starduststorm/earthvenusmars/case/bottom_case.stl

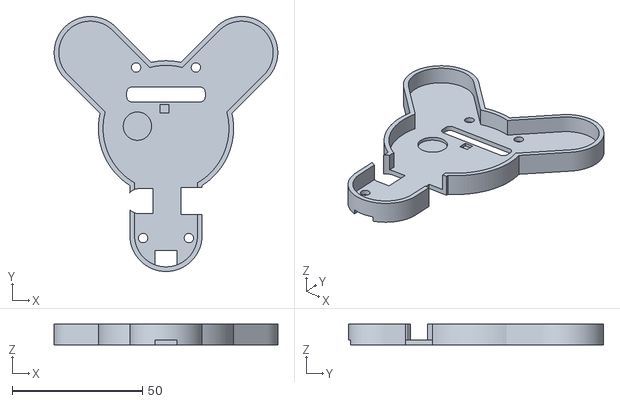
[picture p6: CAD file, 2023-03-20]
case/bottom_case.stl
86.0 x 98.1 x 8.00
