starduststorm/earthvenusmars/programmer/caddy.stl

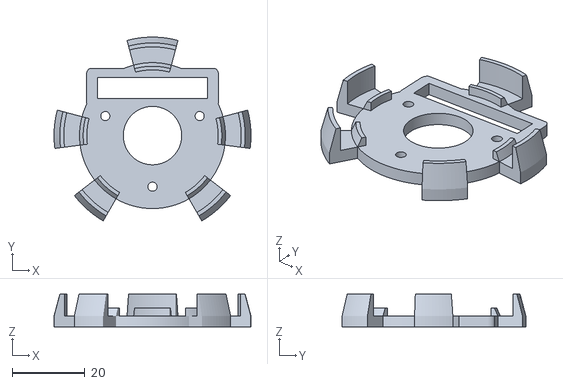
[picture p7: CAD file, 2021-11-03]
programmer/caddy.stl
54.0 x 50.4 x 9.00
