starduststorm/earthvenusmars/case/top_case.stl

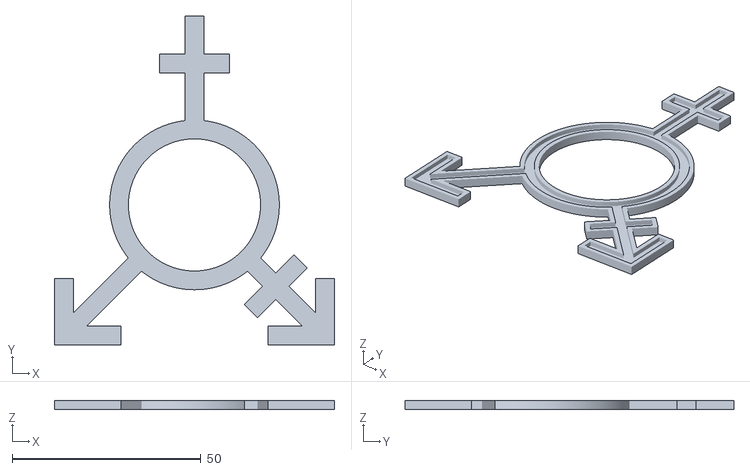
[picture p8: CAD file, 2023-03-20]
case/top_case.stl
74.3 x 87.2 x 2.30
