starduststorm/earthvenusmars/(list of files, cad)

Other CAD files:
case/PI3MK3M_bottom_case.3mf
