starduststorm/earthvenusmars/src/controls.h

#ifndef CONTROLS_H
#define CONTROLS_H

#include <vector>
#include <functional>
#include "Adafruit_FreeTouch.h"

class HardwareControl {
  friend class HardwareControls;
protected:
  virtual void update() = 0;
  int pin;
public:
  HardwareControl(int pin) : pin(pin) {};
  virtual ~HardwareControl() {};
};

/* ------------------ */

typedef std::function<void(uint32_t)> DialHandler;

class AnalogDial : public HardwareControl {
  DialHandler changeHandler = [](uint32_t){};

  uint32_t lastValue = UINT32_MAX;
  unsigned long lastChange;
  bool firstUpdate = true; // always call handler on first update to help set initial values

  void update() {
    uint32_t value;
    if (readValueFunc) {
      value = (*readValueFunc)();
    } else {
      value = analogRead(pin);
    }
    // potentiometer reads are noisy, jitter may be around ±30 or so. 
    // Wait for significant change to notify the handler, but then still allow smooth updates as the pot is turned
    bool significantChange = abs((int)lastValue - (int)value) > updateThreshold;
    bool recentSignificantChange = (millis() - lastChange < smoothUpdateDuration);
    bool endpointsChange = lastValue != value && (value == 0 || value == maxValue);
    
    if (significantChange || recentSignificantChange || endpointsChange || firstUpdate) {
      // logf("pot update: significantChange = %i [%u - %u > %u], recentSignificantChange = %i, endpointsChange = %i", significantChange, lastValue, value, updateThreshold, recentSignificantChange, endpointsChange);
      if (significantChange || endpointsChange) {
        lastChange = millis();
        lastValue = value;
      }
      changeHandler(value);
    }
    firstUpdate = false;
  }

public:
  unsigned updateThreshold = 40; // Value threshold to suppress jitter in the thumbdial
  unsigned smoothUpdateDuration = 500; // Duration (ms) to call handler on every change after threshold is met

  uint32_t (*readValueFunc)(void) = NULL;
  uint32_t maxValue = 1023;

  AnalogDial(int pin) : HardwareControl(pin) {
  }

  void onChange(DialHandler handler) {
    changeHandler = handler;
  }
};

/* ----------------------- */

typedef std::function<void(void)> ButtonHandler;

class SPSTButton : public HardwareControl {
  typedef enum {
    singlePress,
    doublePress,
    longPress,
    doubleLongPress,
    buttonDown,
    buttonUp,
    handlerTypeCount,
  } HandlerType;

  uint32_t buttonDownTime = 0;
  uint32_t singlePressTime = 0;
  bool waitForButtonUp = false;
  
  bool didInit = false;
  
  ButtonHandler *handlers[handlerTypeCount] = {0};

  virtual void initPin(int pin) {
    pinMode(pin, INPUT_PULLUP);
  }

  void onHandler(HandlerType type, ButtonHandler handler) {
    // we go through this handlers dance in order to not spend memory on expensive std::functions for handlers not in use.
    if (handlers[type]) {
      delete handlers[type];
    }
    handlers[type] = new ButtonHandler(handler);
  }

  void doHandler(HandlerType type) {
    logdf("Do button handler: %i", type);
    if (handlers[type])
      (*(handlers[type]))();
  }

  void update() {
    if (!didInit) {
      initPin(pin);
      didInit = true;
    }
    bool buttonPressed = isButtonPressed();
    long readTime = millis();

    if (!buttonPressed && buttonDownTime != 0) {
      doHandler(buttonUp);
    }

    if (waitForButtonUp) {
      if (!buttonPressed) {
        waitForButtonUp = false;
      }
    } else {
      if (!buttonPressed && singlePressTime != 0) {
        if ((!handlers[doublePress] && !handlers[doubleLongPress]) || readTime - singlePressTime > doublePressInterval) {
          // double-press timeout
          doHandler(singlePress);
          singlePressTime = 0;
        }
      }
      if (!buttonPressed && buttonDownTime != 0) {
        if (singlePressTime != 0) {
          // button-up from second press
          doHandler(doublePress);
          singlePressTime = 0;
        } else {
          singlePressTime = readTime;
        }
      } else if (buttonPressed && buttonDownTime == 0) {
        if (readTime - singlePressTime < 15) {
          // The metal buttons sometimes have state jitter leading to a button down around ~10ms after button up. We'll ignore.
          logf("Button jitter detected at %lums, ignoring", readTime - singlePressTime);
          return;
        }
        buttonDownTime = readTime;
        doHandler(buttonDown);
      } else if (buttonPressed && readTime - buttonDownTime > longPressInterval) {
        if (singlePressTime != 0) {
          doHandler(doubleLongPress);
          singlePressTime = 0;
        } else {
          doHandler(longPress);
        }
        // waiting for button up prevents duplicate calling of the longpress handler
        waitForButtonUp = true;
      }
    }

    if (!buttonPressed) {
      buttonDownTime = 0;
    }
  }

public:
  uint16_t longPressInterval = 500;
  uint16_t doublePressInterval = 400;

  SPSTButton(int pin) : HardwareControl(pin) { }
  ~SPSTButton() {
    for (int i = 0; i < handlerTypeCount; ++i) {
      if (handlers[i]) {
        delete handlers[i];
      }
    }
  }

  virtual bool isButtonPressed() {
    // HACK: on EVM hardware 2+, the Colors button is wired to Arduino Zero's TX LED pin, which causes sporatic HIGH reads
#if EVM_HARDWARE_VERSION >= 2
    noInterrupts();
    pinMode(pin, INPUT_PULLUP);
#endif
    int read = (digitalRead(pin) == LOW);
#if EVM_HARDWARE_VERSION >= 2
    interrupts();
#endif
    return read;
  }

  // guestural handlers that handle all timeouts/delays, i.e. singlePress handler will only be called if doublePress is not triggered.
  void onSinglePress(ButtonHandler handler) {
    onHandler(singlePress, handler);
  }
 
  void onDoublePress(ButtonHandler handler) {
    onHandler(doublePress, handler);
  }

  void onLongPress(ButtonHandler handler) {
    onHandler(longPress, handler);
  }

  void onDoubleLongPress(ButtonHandler handler) {
    onHandler(doubleLongPress, handler);
  }

  // simple handlers. onButtonUp may be called in addition to the e.g. longPress handler if both are set. onButtonUp will be called twice during doublePress.
  void onButtonDown(ButtonHandler handler) {
    onHandler(buttonDown, handler);
  }

  void onButtonUp(ButtonHandler handler) {
    onHandler(buttonUp, handler);
  }
};

class TouchButton : public SPSTButton {
  Adafruit_FreeTouch *touchObj;
  void initPin(int pin) { } // no-op, skip SPSTButton init and do pin init in constructor
  bool touchRegistered = false;
  uint16_t avgSample = 0;
  const uint16_t avgSampleCount = 3;
public:
  uint16_t touchThreshold = 500; // sample above (10-bit) threshold will be considered touch down
  uint16_t touchReleaseBuffer = 100; // sample must fall below threshold-buffer for touch release

  TouchButton(int pin, oversample_t oversample, series_resistor_t seriesResistor, freq_mode_t freqMode) : SPSTButton(pin) {
    touchObj = new Adafruit_FreeTouch(pin, oversample, seriesResistor, freqMode);
    touchObj->begin();
  }

  ~TouchButton() {
    delete touchObj;
  }

  bool isButtonPressed() {
    uint16_t sample = touchObj->measure();
    if (sample == (uint16_t)-1) {
      logf("touch sample failed");
      return touchRegistered;
    }
    assert(touchThreshold > touchReleaseBuffer, "touchThreshold must be > touchReleaseBuffer");

#if EVM_HARDWARE_VERSION==3
  /*
  I think the pin 17 touch pad has a higher baseline read perhaps because it routes through a via underneath the mcu. Let
  Idle reads on pins 8, 17, and 19 across 3 different units:
  Touch Samples: 181, 323, 147
  Touch Samples: 175, 317, 142
  Touch Samples: 179, 322, 145
  */
  if (pin == 17) {
    sample = map(sample, 310, 1023, 150, 1023);
  }
#endif

    avgSample = ((avgSampleCount * avgSample) + sample) / (avgSampleCount + 1);
    if (avgSample > touchThreshold) {
      touchRegistered = true;
    } else if (avgSample < (uint32_t)(touchThreshold - touchReleaseBuffer)) {
      touchRegistered = false;
    }
    return touchRegistered;
  }

  int measure() {
    return touchObj->measure();
  }
};

/* --------------------- */

class HardwareControls {
private:
  std::vector<HardwareControl *> controlsVec;
public:
  ~HardwareControls() {
    for (auto control : controlsVec) {
      delete control;
    }
    controlsVec.clear();
  }

  SPSTButton *addButton(int pin) {
    SPSTButton *button = new SPSTButton(pin);
    controlsVec.push_back(button);
    return button;
  }

  TouchButton *addTouchButton(int pin, oversample_t oversample=OVERSAMPLE_4, series_resistor_t seriesResistor=RESISTOR_0, freq_mode_t freqMode=FREQ_MODE_NONE) {
    TouchButton *button = new TouchButton(pin, oversample, seriesResistor, freqMode);
    controlsVec.push_back(button);
    return button;
  }

  AnalogDial *addAnalogDial(int pin) {
    AnalogDial *dial = new AnalogDial(pin);
    controlsVec.push_back(dial);
    return dial;
  }

  void update() {
    for (HardwareControl *control : controlsVec) {
      control->update();
    }
  }
};

#endif
