starduststorm/earthvenusmars/(commit log)

2020-10-08 initial commit of trans symbol wearable led project, wip, just finish first pass on edge-cut-drawing code
    [leds.sch, trans_symbol.kicad_pcb, trans_symbol.sch]
2020-10-08 fix spokes to match the non-uniform spacing that the symbol apparently has
    [trans_symbol.kicad_pcb]
2020-10-09 start working on spokes
    [leds.sch, trans_symbol.kicad_pcb, trans_symbol.sch]
2020-10-10 clean up various point-like object types; tweak Edge.Cuts to be precise overlap in order to fix pcbnew thinking it wasn't a closed shape, but turns out this was also a bug fixed in kicad-5.1.3 so I'm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
    [leds.sch, trans_symbol.kicad_pcb]
2020-10-11 first pass on complete trans symbol
    [trans_symbol.kicad_pcb]
2020-10-11 flip arrow without cross to save a via
    [trans_symbol.kicad_pcb]
2020-10-11 fix pixel orientation on arrow & cross
    [trans_symbol.kicad_pcb]
2020-10-11 hide pixel reference labels
    [trans_symbol.kicad_pcb]
2020-10-20 fix pixel orientation on arrow; add via for GND out of each LED (we cannot delete vias programmatically due to a crasher, so layout is manual from here on out); choose pins for SPI; wire up SPI & USB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
    [leds.sch, trans_symbol.kicad_pcb, trans_symbol.sch]
2020-10-20 add pcb layout as it was before adding vias, as a backup
2020-10-20 add test code for running leds on the chosen SPI pins
2020-10-20 add symbol cache lib to repo; one last tweak to layout to shift led placement - comment out via code in order to leave vias intact (where they are is fine) without crashing
2020-10-20 first pass on manual layout of board including led power traces & samd circuitry; key idea: take out the usb port and solder the usb data & power directly to the board, i.e. it'll have its own cable 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
    [leds.sch, trans_symbol.kicad_pcb, trans_symbol.sch]
2020-10-20 add a decoupling capacitor on +5V for LEDs
    [leds.sch, trans_symbol.kicad_pcb, trans_symbol.sch]
2020-10-20 re-add 5V line that was removed
    [trans_symbol.kicad_pcb]
2020-10-20 re-layout chip circuitry to clean it up a bit and make room for a button on each spoke; add a stub for a button
    [trans_symbol.kicad_pcb, trans_symbol.sch]
2020-10-21 add an i2s microphone on default arduino zero i2s pins
    [trans_symbol.kicad_pcb, trans_symbol.sch]
2020-10-21 add three buttons; untested beacuse I've bricked my samd board again, trying to get it to come back alive
    [trans_symbol.kicad_pcb, trans_symbol.sch]
2020-10-22 rename project to something a bit more fun
    [earthvenusmars.kicad_pcb, earthvenusmars.sch]
2020-10-22 move kicad files to ./board
    [earthvenusmars.kicad_pcb, earthvenusmars.sch, leds.sch]
2020-10-22 move button 2 to pin 30 to avoid a via
    [earthvenusmars.kicad_pcb, earthvenusmars.sch]
2020-10-22 add kicad symbol cache which was somehow missing
2020-11-01 make platformio project cause Arduino.app does't even support cmd+clicking a symbol; crib util.h from belt
2020-11-02 map buttons pins correctly, tested with samd21g_breakout_v1 using arduino zero firmware
    [main.cpp]
2020-11-24 proof of concept for entering low-power state when the brightness dial is all the way down, using the adc, then waking the system back up when the brightness dial is turned up again
    [earthvenusmars.kicad_pcb, earthvenusmars.sch]
2020-11-25 add pads on back for bootloader programming/reset and for driving the leds externally
    [earthvenusmars.kicad_pcb, earthvenusmars.sch]
2020-11-25 fix led GND vias that were isolated from or poorly connected to the GND fill
    [earthvenusmars.kicad_pcb]
2020-12-04 scoot pot dial around a bit
    [earthvenusmars.kicad_pcb]
2020-12-04 add footprint for 3-hole safety pin attachment point; place 3 attachments on board; scoot things around for neatness/GND flow
    [earthvenusmars.kicad_pcb, earthvenusmars.sch]
2020-12-07 remove my name from the KMR731NG LFS footprint
    [earthvenusmars.kicad_pcb]
2020-12-07 add kicad fp-lib-table file that seems to be for project-specific libraries
2020-12-07 sign it
    [earthvenusmars.kicad_pcb]
2020-12-07 fix mic gnd connection; tweaks for printing/assembly
    [earthvenusmars.kicad_pcb]
2020-12-07 ensure microphone is present in footprint position (centroid) file
    [earthvenusmars.kicad_pcb]
2020-12-08 add part number to a "Designation" field that will be output by the bom_csv_grouped_by_value script that looks like a better alternative than what I sent to the fab this time; remove (opal) from part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
    [earthvenusmars.kicad_pcb, earthvenusmars.sch]
2020-12-08 crib a bunch of code from the belt to start fleshing out the software side of this project. builds, but untested
2020-12-08 stop trying to sprintf floats because arduino-samd-core cannot sprintf floats (and this was crashing, usually)
    [main.cpp, util.h]
2020-12-09 just in time to negotiate with the fab, rewire the whole damn thing because it was really bothering me that the leds in the cross and arrow were not oriented consistently; also remove paste from debu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
    [earthvenusmars.kicad_pcb]
2020-12-09 change APA102 footprint to use the 6-pad variant, not 8. these are cheaper from pcbway, though still expensive enough that I'm going to order my own later anyawy
    [earthvenusmars.kicad_pcb]
2020-12-09 schematic changes for apa102-2020-6 footprint
    [leds.sch]
2020-12-09 change USB pin connector to 5-pin to handle the ID pin from usb-micro
    [earthvenusmars.kicad_pcb, earthvenusmars.sch]
2020-12-09 I deleted a single layout alignment target and kicad generated this gigantic diff
    [earthvenusmars.kicad_pcb]
2020-12-14 rearrange F.Fab and B.Fab layers for clarity to aid assembly engineers; use the larger 0603 footprint for ferrite bead because it's way more manageable and I have the parts
    [earthvenusmars.kicad_pcb, earthvenusmars.sch]
2020-12-15 hide J4 connector label ugh
    [earthvenusmars.kicad_pcb]
2020-12-15 correct part number for new ferrite bead
    [earthvenusmars.sch]
2020-12-26 first WIP pattern for working prototype!
2020-12-27 more flag palettes; add concept for "Coupling" pattern
2020-12-28 factor adc/power code into power.h and clean it a up a little; add sleep/wake animations; buttons advance patterns for now
2020-12-29 actually add power.h; tweaks to Downstream & FastLED delay
2021-01-04 clean up new edge-directions code in BitsFiller, generalize flowing to allow fade-up on each path; BitsFiller color cycling; argument logging for assertions
2021-01-05 reduce flicker due to brightness dial jitter using AnalogDial class from the belt; fix a bug where we wouldn't enter sleep mode when the brightness dial was quickly thrown to its lowest position
    [controls.h, main.cpp, power.h]
2021-01-11 add new ChargePattern which will probably be run with buttons later on; add Bit handlers to BitsFiller to allow for colors customization etc., rather than trying the ever-expanding list of enums and 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
2021-01-17 use pixel buffers to fix global fadedown in BitFiller
    [PatternManager.h, drawing.h, ledgraph.h, patterns.h]
2021-01-18 use new buffers to give Coupling a much more polished treatment
2021-01-18 Basic button functions for changing patterns; handle buttons with lambdas instead of function ptrs; access Charge pattern using long presses; start working on color/palette changing via button presse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
2021-01-19 color/palette selection for Charge
2021-01-19 fix a signedness issue in reducing pot jitter; log brightness changes
    [controls.h, power.h]
2021-01-31 committing some fft-related stubs that I had only just started testing when I broke my prototype. like a week ago fml I need to make a new one
    [PatternManager.h, patterns.h]
2021-01-31 add an OpenSCAD-based rough design for a case for the pcb; needs a cutout for the brightness thumbdial and a way to snap the halves together
    [shell_case.scad]
2021-01-31 add a case cutout for the thumbdial
    [shell_case.scad]
2021-02-05 fix thumbdial cutout position
    [shell_case.scad]
2021-02-11 stub for new kicad project for a programmer board with spring pins; move project-specific footprints into a shared footprints lib
    [earthvenusmars.kicad_pcb, programmer.kicad_pcb, programmer.sch]
2021-02-13 disable Sound-related test code because it is crashing on launch again (or otherwise has bricked my boards); fix "test pattern" code to not instantiate test pattern at global scope; random small twea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
    [PatternManager.h, controls.h, patterns.h, power.h]
2021-02-13 first complete pass at a programmer pcb & accompanying 3d-printable caddy; create footprints for programmer pins including the first fab run as well as a new design for v2 programmer pins
    [caddy.scad, programmer.kicad_pcb, programmer.sch]
2021-02-13 adopt v2 programmer pins on EVM board
    [earthvenusmars.kicad_pcb, earthvenusmars.sch]
2021-02-13 I reloaded *one* footprint from the footprint library and kicad generated this vomit of a diff
    [earthvenusmars.kicad_pcb]
2021-02-13 fix build issues; tested and works
    [PatternManager.h]
2021-02-13 set Sound up for future testing; it's not crashing now; but it's also not picking up any audio, hardware suspected faulty since test program worked before and doesn't now
    [PatternManager.h, patterns.h]
2021-02-14 change screw drill size to 1.25mm for M3 screws (which apparently have 3mm major dimension and expect a 2.5mm drill)
    [caddy.scad, programmer.kicad_pcb]
2021-02-14 tweak to avoid "Object may not be a valid 2-manifold" issue in OpenSCAD, I think because this tweak avoids a coincident external edge
    [caddy.scad]
2021-02-14 correct footprint for SMD SWD socket (part 3221-10-0300-00 ordered from digikey)
    [programmer.kicad_pcb, programmer.sch]
2021-02-14 decorate a little
    [programmer.kicad_pcb]
2021-02-14 tiny polish tweaks
    [programmer.kicad_pcb]
2021-02-14 decoration on bottom too
    [programmer.kicad_pcb]
2021-03-15 Sound is working! two test patterns present, not great yet; fft frequency binning is unfortunately linear, but at least it's reliable; i2s power consumption while sleeping not tested yet
2021-04-28 WIP on a snap notch for case
    [notch.scad]
2021-04-28 committing stl for caddy
    [caddy.stl]
2021-04-28 minor changes to soundbits; memory logging improvements; vasprintf bugfix; wip concept for heartbeat pattern
    [AudioManager.h, PatternManager.h, main.cpp, palettes.h, patterns.h, util.h]
2021-04-28 scoot a trance around under the samd21 for aesthetics
    [earthvenusmars.kicad_pcb]
2021-04-29 change usb port footprint to 4-pin 2.54mm. I still don't like my options for using a usb micro port on the back. not that glue is any better...
    [earthvenusmars.kicad_pcb, earthvenusmars.sch]
2021-05-14 checkpoint for shell case that prints correctly on my new prusa i3 mk3s by including more of a back panel. fits board correctly though doesn't quite fit a bar pin
    [shell_case.scad]
2021-05-14 tweak to add print tolerance to progarmmer caddy; I had to file the first one down a little to fit
    [caddy.scad]
2021-05-14 tweak thumbdial position and cable cutout
    [shell_case.scad]
2021-05-31 concept for smd usb pads on bottom of board + a pass at the shell case cable management for that
    [earthvenusmars.kicad_pcb, earthvenusmars.sch, shell_case.scad]
2021-05-31 tweak some traces and vias for slightly better gnd flow
    [earthvenusmars.kicad_pcb]
2021-05-31 new plan for spoke buttons: touch buttons. schematic changes for new button layout; add footprints for new touch buttons; rewire new and existing buttons; re-layout linreg and power circuity for bett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
    [earthvenusmars.kicad_pcb, earthvenusmars.sch]
2021-06-01 bunch of spacing & routing tweaks
    [earthvenusmars.kicad_pcb]
2021-06-01 reposition buttons farther away from touch buttons to avoid accidental touch + better overall spacing
    [earthvenusmars.kicad_pcb, earthvenusmars.sch]
2021-06-01 decorate with a larger trans symbol and add a new signature
    [earthvenusmars.kicad_pcb]
2021-06-01 add hackable ports for led spi & i2c for who knows what reason
    [earthvenusmars.kicad_pcb, earthvenusmars.sch]
2021-06-01 reconnect vddio back to 3.3v, got disconnected likely by b136dde during redo
    [earthvenusmars.kicad_pcb]
2021-06-02 change 1uF cap to an 0603 because the 0805 one was so thick it was impacting the case design
    [earthvenusmars.kicad_pcb, earthvenusmars.sch]
2021-06-02 no-conn flags to suppress old drc errors
    [leds.sch]
2021-06-02 move led & i2c hack pads closer to programmer pads in case I ever want to add those to a programmer caddy
    [earthvenusmars.kicad_pcb]
2021-06-02 move crystal down a bit for compactness
    [earthvenusmars.kicad_pcb]
2021-06-05 move usb pads up a little to give the usb cables more room for stabilization before poking out the bottom of the device
    [earthvenusmars.kicad_pcb, shell_case.scad]
2021-06-05 add a usb-micro port (I know). including both usb styles on this prototype stage to try them both out and compare
    [earthvenusmars.kicad_pcb, earthvenusmars.sch]
2021-06-05 add a thermistor that I can use to manage thermals
    [earthvenusmars.kicad_pcb, earthvenusmars.sch]
2021-06-05 scoot some components around slightly to center on 90,90
    [earthvenusmars.kicad_pcb]
2021-06-05 move touch pin 2 because AdaFruit_FreeTouch only supports PA02 thru PA07 for self-capacitance; run power to mic and VDDANA on the far side of the VDDIO capacitor to save a via, I think this'll be fin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
    [earthvenusmars.kicad_pcb, earthvenusmars.sch]
2021-06-06 remove solder paste that stubbornly keeps getting added to some pads
    [earthvenusmars.kicad_pcb]
2021-06-06 futz with the copper near the usb port gnd; hide c13 label; prep for fab
    [earthvenusmars.kicad_pcb]
2021-06-08 slightly reduce the percentage of time that mars & venus are chosen during coupling
2021-06-08 refactor most bitdirections-related code to use a memory-compacted EdgeTypesPair implementation rather than the god-awful vector implementation I had before. sizeof(Bit) down to 24 from 36; shaved 20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
    [ledgraph.h, patterns.h]
2021-06-14 tweak touch pad footprints for appearance after seeing how v2 prints look
    [earthvenusmars.kicad_pcb]
2021-06-16 thermistor series resister marked as 10k
    [earthvenusmars.kicad_pcb, earthvenusmars.sch]
2021-06-17 fix a bug where the brightness dial wouldn't get an interrupt at program start, leaving brightness at 0 until changed. this was only reproducing on evm board v2, I don't know why
    [controls.h, power.h]
2021-06-17 add build env for board v2; add support for qtouch capacitive touch pads via the Adafruit FreeTouch library; basic implementation of button configuration for board v2; fix a hang in audio if no mic i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
    [AudioManager.h, controls.h, main.cpp]
2021-06-17 add support for thermistor reads with a custom analogRead function that restores settings needed by the ADC interrupt-driven brightness dial; scale brightness down as temperature increases (partially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
    [earthvenusmars.sch]
2021-06-18 overhaul color system for consistency across patterns; add support for several new flag types; add palette autorotate as a toggle; add pattern rotate (timeout/random); support board v2 and partially 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
2021-06-21 change µ to u in micro-faraday labels for consistency and cause it's easier to search for and everyone understands it
    [earthvenusmars.sch]
2021-07-01 remove USB pads; scoot USB port around a little; revert bottom board to be rounded again, no need to accomodate usb cable; scoot brightness dial around for case/usability considerations; lots of trac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
    [earthvenusmars.kicad_pcb]
2021-07-01 shell case updates for board tweaks; also add cutouts for thermistor, remove usb pad channel
    [shell_case.scad]
2021-07-01 work around an issue where the colors button was triggering sporatically on its own
    [controls.h]
2021-07-01 factor some pattern-palette update stuff for cleanliness; compile out thermistor code on v1; add pride flags to main palette rotation; tweaks
2021-07-01 very dirty gain management for sound responsiveness, implemented the morning before I was gonna demo this; also a tweak for Downstream to avoid time drift
    [patterns.h]
2021-07-11 add a power switch. ugh. but it's going to prevent the device from waking up in a backpack and stuff; not to mention power draw is way too high for sleep right now
    [earthvenusmars.kicad_pcb, earthvenusmars.sch]
2021-07-11 clean up schematic a bit; reroute +5v to save a via
    [earthvenusmars.kicad_pcb, earthvenusmars.sch]
2021-07-14 move github url slightly up
    [earthvenusmars.kicad_pcb]
2021-07-25 small tweaks to Fab layers for fab run; add two NPTHs for potential case attachment
    [earthvenusmars.kicad_pcb]
2021-07-25 add missing footprint for power switch ('no license' footprint from https://gitlab.geofront.co.uk/mwoods/kicad-libs/blob/master/kicad-library-master/mods/COPAL-MFS101D-6-Z.kicad_mod)
2021-07-26 refill zones
    [earthvenusmars.kicad_pcb]
2021-07-28 put a bandaid over a type issue stemming from EdgeTypes still being around as uint8_t to manage bitwise-operated EdgeType, since EdgeType is an unbased enum
    [ledgraph.h]
2021-07-29 fix an issue where leds might blink briefly on wake from sleep
    [power.h]
2021-07-29 only create a std::function for in-use button handlers since each is at least 16 bytes, leading my 5 'buttons' to consume 688 bytes cold. down to ~300 now
2021-07-29 WIP: move pin config out of main into config.h; move controls out of main into pattern manager; pattern manager always runs Charge; charge is activated by touch-down and made persistent with long-pre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
    [PatternManager.h, config.h, ledgraph.h, main.cpp, patterns.h, util.h]
2021-07-30 rework buffering so that there's a global pixel buffer, and one per-pattern, rather than one per-BitsFiller. this saves a lot of memory while looking pretty much the same. consolidate CustomDrawingCo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
    [PatternManager.h, drawing.h, ledgraph.h, main.cpp, patterns.h]
2021-07-30 fix v1 with new chargepattern changes
    [PatternManager.h, main.cpp]
2021-07-30 found the crash - this return was removed accidentally when I removed the unused leaf behavior; crash would happen when a bit both a) hit a leaf with nowhere to go and b) ran over its lifespan, withi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
    [patterns.h]
2021-07-30 remove debug code from Charge reword & memory improvements; overall memory usage hard to measure but I'd guess I shaved a good 1-2KB off the worst use SRAM cases
2021-08-02 more micro-optimizations, this time avoid copying a vector of fft data
    [AudioManager.h, patterns.h]
2021-08-11 new welcome animations for power-on & pattern autorotate; long-presses for both buttons now always enable autorotate, even if it was already on, shows the welcome again, for predictability's sake
2021-08-12 fade down the active pattern somewhat while Charge is running
2021-08-12 reset tracked flag colors on pattern change since some patterns dirty them
    [PatternManager.h, palettes.h]
2021-08-12 fix an issue where we were creating a FlagColorManager:PaletteRotation (and logging) on every frame of the pattern-rotation-welcome animation
    [PatternManager.h]
2021-08-12 lower temperature-scaling threshold cause it's quite easy to get the device to 60+ degrees C which is hot
2021-08-13 fix a potential crasher on v1
    [PatternManager.h]
2021-08-16 add scripts for flashing bare devices using gdb + blackmagic probe; update programmer README
2021-08-16 add some part numbers to designation fields because fab often doesn't find the parts in other fields
    [earthvenusmars.sch]
2021-08-17 unhide SW3 and RV1 labels for fab use
    [earthvenusmars.kicad_pcb]
2021-09-14 i just....... you know when you spend hours and hours on a project to make sure everything is functional & you triple check everything, only to go on break it when you remove some debugging code? I g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
    [earthvenusmars.kicad_pcb, earthvenusmars.sch]
2021-09-15 enlargen mounting holes somewhat; scoot labels around for aesthetic
    [earthvenusmars.kicad_pcb]
2021-09-15 don't clear Charge on pattern change, that way you can put on your preferred spoke and it'll stay on during pattern autorotate
2021-10-01 fix a bug where brightness was reduced due to charge pattern appearing to be active; problem more apparently now that charge pattern isn't cleared on pattern change
    [patterns.h]
2021-10-01 faster max for temperature downscaling
2021-10-01 update programmer rig to have space for a the bar pin attachments I've been using, otherwise once a bar pin is attached the programmer rig can no longer be used
    [caddy.scad, caddy.stl, programmer.kicad_pcb]
2021-10-27 actually enlarge drills for top mounting holes - 07b4abe only enlarged the footprint, which ended up being plating around the outside, not the drill itself
    [earthvenusmars.kicad_pcb]
2021-11-03 fix caddy fit tolerance
    [caddy.scad, caddy.stl]
2021-11-15 disable red-ring sleepwake blink since we have a power switch now & having a second "on/off" state is confusing. the brightness dial should just be a brightness dial, the fact that the chip sleeps at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
2021-11-15 fix a leak that never happens, assert sanity
    [PatternManager.h]
2021-11-24 new, embellished, design for top case diffuser; clips on bottom case to attach. I don't like how the diffuser also catches light around the edges tho; add cutout for power switch; v3 position for thu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
    [shell_case.scad]
2021-11-24 idea for top case being the symbol only that snaps onto the leds; not practical.
    [shell_case.scad]
2021-12-01 support changing the palette for individual charged spokes; update readme with the new chords
2021-12-08 optional "pacemaker" feature that beats the heartbeat pattern in response to RISING pulses on SDA pin
2021-12-08 fix the SDA/SCL labels being swapped from the pins they're actually connected to; enlargen these and the led pads
    [earthvenusmars.kicad_pcb, earthvenusmars.sch]
2021-12-08 update image of assembled board to latest revision (with power switch)
2022-01-20 placeholder second spoke pattern; several FIXMEs in place
    [PatternManager.h, ledgraph.h, patterns.h]
2022-01-20 fix a fixme so spoke patterns don't have to care if they're in shared palette mode or not
    [palettes.h, patterns.h]
2022-02-01 fix spokes palettes being persistent across starting & stopping the spoke; when changing spoke palette, start from the current shared palette
    [palettes.h, patterns.h]
2022-07-13 adopt a different part for the two pushbuttons in hopes to find one more durable; add custom footprint for new button; relayout pcb to accomodate larger button size
    [earthvenusmars.kicad_pcb, earthvenusmars.sch]
2022-07-13 add mounting holes on every spoke to properly secure a diffuser
    [earthvenusmars.kicad_pcb]
2022-07-15 use 4 attachment drills instead of 6; add attachment drills to case scad; make drills slightly larger to accomodate M2 screw spacers; remove some dead code in scad
    [earthvenusmars.kicad_pcb, shell_case.scad]
2022-07-15 update to kicad6 file format; remove some old files
    [earthvenusmars.kicad_pcb, earthvenusmars.kicad_sch, leds.kicad_sch]
2022-07-15 label power and brightness controls
    [earthvenusmars.kicad_pcb]
2022-07-15 make touch pads 40% larger; some relayout
    [earthvenusmars.kicad_pcb]
2022-07-16 remove extra holes from shell case - unsaved changes in openscad
    [shell_case.scad]
2022-07-23 ignore kicad's new backups folders
2022-09-05 put the atsamd21g footprint in the project since it seems to be missing from the footprint library
    [earthvenusmars.kicad_pcb]
2022-11-17 remove old-format kicad file
    [leds.sch]
2022-11-17 port from schematic back into pcb, I think this is all the internal changes due to kicad 6
    [earthvenusmars.kicad_pcb]
2022-11-18 first pass on adopting SK9822-EC20 pixels to replace the APA102-2020
    [earthvenusmars.kicad_pcb, earthvenusmars.kicad_sch, earthvenusmars.sch, leds.kicad_sch]
2023-01-20 first pass on adopting USB-C (is this a good idea even)
    [earthvenusmars.kicad_pcb, earthvenusmars.kicad_sch, leds.kicad_sch]
2023-01-20 trace & footprint tweaks to fix DRC errors & warnings
    [earthvenusmars.kicad_pcb]
2023-01-20 fix/remove some 3d models that had missing paths
    [earthvenusmars.kicad_pcb]
2023-01-20 exclude non-assembly items from centroid & bom files; remove non-assembly pads from Paste layers
    [earthvenusmars.kicad_pcb]
2023-01-21 move several symbols that were in the 'rescue' lib into the project-wide lib awkwardly in the .pretty file
    [earthvenusmars.kicad_pcb, earthvenusmars.kicad_sch]
2023-01-21 kicad_prl -> .gitignore
2023-01-27 fix ERC issues and most DRC issues; only remaining issues are clipped Edge.Cuts which are intentional
    [earthvenusmars.kicad_pcb, earthvenusmars.kicad_sch, leds.kicad_sch]
2023-01-31 add part numbers for ferrite bead and thermistor, requested by assembler (and these are the parts they selected last time)
    [earthvenusmars.kicad_pcb]
2023-02-25 fix a semi-rare crasher resulting from the charge spokePattern being destroyed after an idle time even though it was reactivated by a new touch, needed to setActive again; leave in some of the debug 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
    [controls.h, patterns.h, util.h]
2023-02-25 fix a missing va_end path found by static analyzer; no known repros
    [util.h]
2023-02-25 fix v1 build, runtime untested
    [PatternManager.h]
2023-03-20 update case for v3 + using glue-on pins
    [PI3MK3M_bottom_case.3mf, bottom_case.stl, shell_case.scad, top_case.stl]
2023-03-20 work around an issue where the new metal buttons would jitter a second press during release; fix press times logic to be unsigned, otherwise it would break at around 50 days uptime lol
    [controls.h]
2023-03-20 keep a short running average of touch samples to smooth out jitter
    [controls.h]
2023-05-24 fix some EVM_HARDWARE_VERSION uses that were too specific; add deployment target to gdb upload
    [controls.h, main.cpp, power.h]
2023-11-08 fix 6051148 bc i am smrt
    [controls.h, power.h]
2024-01-04 remove a couple unused footprints
2024-09-06 compensate for extra capacitance in the venus touch line; lower capacitance threshold to make worst-case touch responsiveness better
2024-09-06 slightly stricter temperature scaling
2025-09-14 kicad8 format
    [earthvenusmars.kicad_pcb, earthvenusmars.kicad_sch, leds.kicad_sch]
2025-09-14 add 3d model for brightness dial
    [earthvenusmars.kicad_pcb]
2025-09-14 fix some more paths
    [earthvenusmars.kicad_pcb]
